YMNKTD/ColourPass-Vespera/design-log/part-05-colour-recognition-and-code-refinement/Colour Calibration Reference Table.xlsx

Colour | R | G | B | C | Ticket Type
RED | 153 | 1997 | 143 | 1328 | Invalid
ORANGE | 196 | 813 | 152 | 1147 | Invalid
PINK | 244 | 1177 | 159 | 681 | Invalid
YELLOW | 108 | 260 | 70 | 505 | Valid — Static
GREEN | 356 | 217 | 105 | 595 | Valid — Static
BLUE | 4852 | 1405 | 286 | 391 | Valid — Ambient
PURPLE | 483 | 1594 | 252 | 671 | Valid — Ambient
WHITE | 103 | 175 | 50 | 185 | N/A (prevent misidentification)
BLACK | 56 | 135 | 32 | 166 | N/A (prevent misidentification)
Background | 52 | 126 | 30 | 154 | N/A (prevent misidentification)
