YMNKTD/ColourPass-Vespera/design-log/part-01-colour-sensing/colour_sensor_testing_blue.jpg

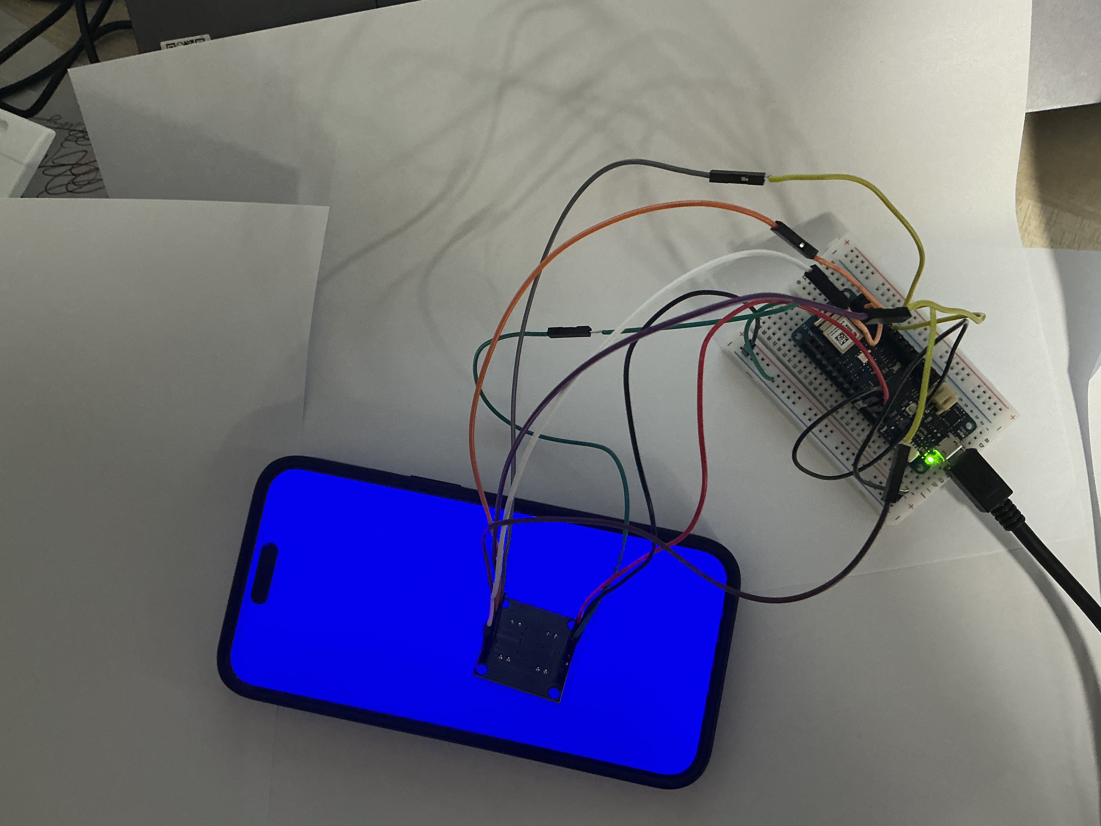
design-log/part-01-colour-sensing/colour_sensor_testing_blue.jpg
