YMNKTD/ColourPass-Vespera/design-log/part-01-colour-sensing/colour_sensor_testing_red.jpg

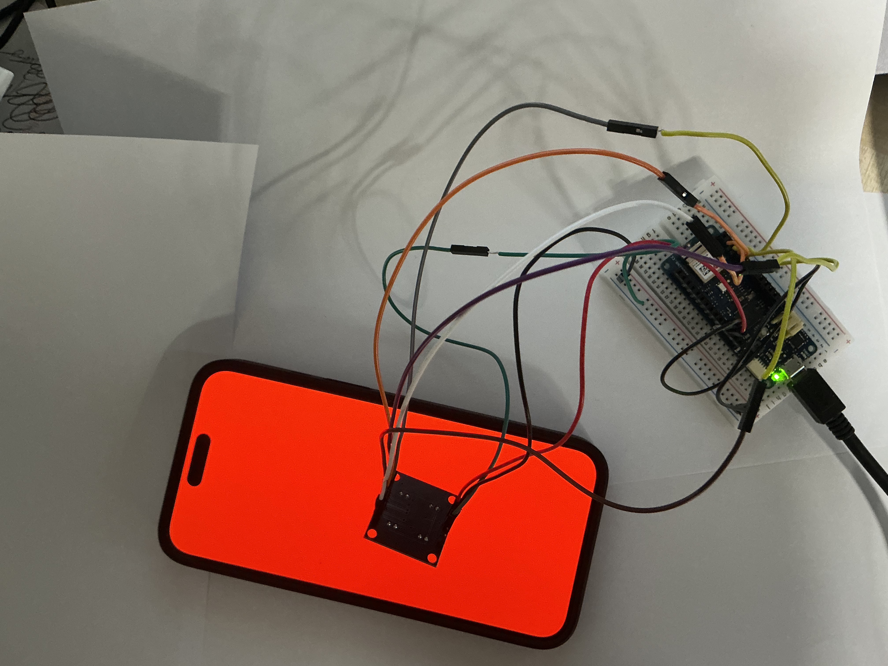
design-log/part-01-colour-sensing/colour_sensor_testing_red.jpg
