YMNKTD/ColourPass-Vespera/code/arduino_secrets.h.example.h

//Change this file before use
#define SECRET_SSID "Your Wifi"
#define SECRET_PASS "The Password of your Wifi"

#define SECRET_SSID1 ""
#define SECRET_PASS1 ""

#define SECRET_MQTTUSER ""
#define SECRET_MQTTPASS ""
