YMNKTD/ColourPass-Vespera/(commit log)

2026-10-20 Update design log with revised touch sensor design
    Added revised design details and clarified touch sensor functionality.
2026-10-25 Add log for Part 01 Colour Sensor Testing
    Document initial testing results and observations for the DFRobot colour sensor with Arduino MKR WiFi 1010.
2026-10-25 Upload some pictures of the circuit and testing
    Upload some pictures of the circuit and testing process for part 01
2026-10-25 Enhance README with sensor readings and testing method
    Added images of sensor readings for different colors and updated the testing method section.
2026-10-28 Add .gitkeep for hardware integration and calibration
2026-10-28 Create README for hardware integration and calibration
    Added README for hardware integration and colour calibration, detailing objectives, hardware components, testing procedures, and calibration steps.
2026-10-28 Update README with I2C testing result and code link
    Added I2C testing result image and code reference.
2026-10-28 Refactor ColourPass code for clarity and touch controls
    Refactor code for clarity and maintainability, updating variable names and restructuring functions to improve readability. Added touch control features for calibration and background checks.
2026-10-29 Upload the 1st version for the project
    In this version, colour still need to be detected after starting the prototype. Then, different modes can work smoothly.
2026-10-29 Upload some images of part 03
    The switch and the battery have been added to the circuit.
2026-10-30 Upload Part 04 pictures
    After this step, we can see the prototype. But I found some small issue in Part 03 and I gonna change it soon.
2026-10-30 Update README with prototype construction details
    Added detailed construction process and design iteration for the ColourPass prototype, including objectives, materials, and testing observations.
2026-10-31 Upload Colour Calibration Reference Table
2026-10-31 Revise README for Part 05 — Colour Recognition updates
    Updated README.md for Part 05 to include an overview of colour recognition improvements, on-site calibration details, code refinements for demonstration, lighting tests, and observations.
2026-11-01 Add initial concept and prototype design sketches
2026-11-01 Update version in serial print statement
