YMNKTD/ColourPass-Vespera/design-log/part-03-mqtt-integration-and-lighting-control/Vespera_Simulation_Test_Yellow.jpg

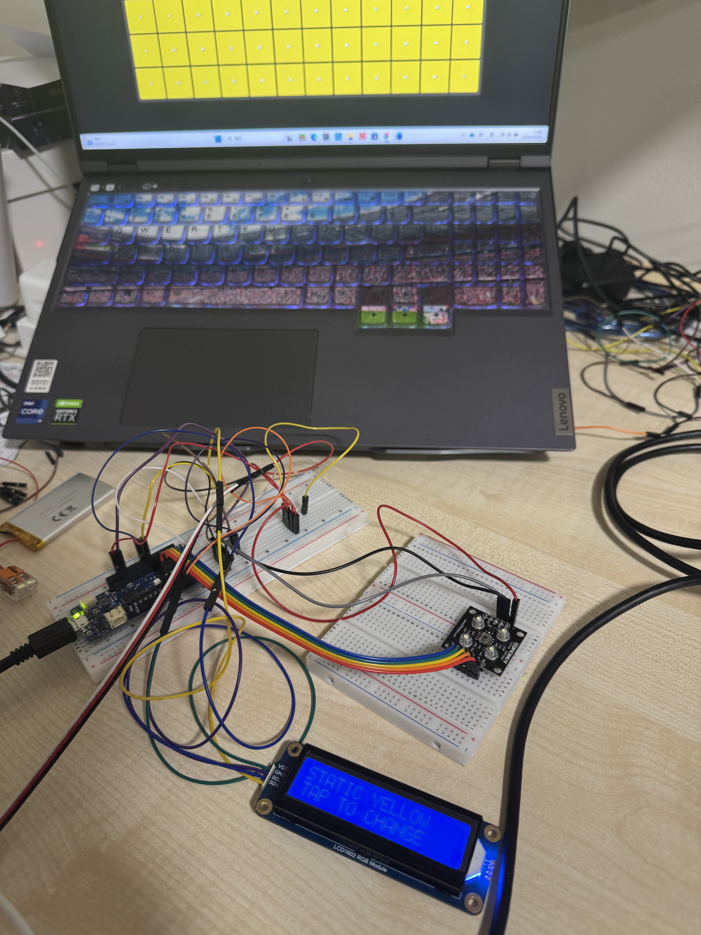
[picture p23: design-log/part-03-mqtt-integration-and-lighting-control/Vespera_Simulation_Test_Yellow.jpg]
design-log/part-03-mqtt-integration-and-lighting-control/Vespera_Simulation_Test_Yellow.jpg
