YMNKTD/ColourPass-Vespera/design-log/part-03-mqtt-integration-and-lighting-control/Vespera_Simulation_Test_BlueMood.jpg

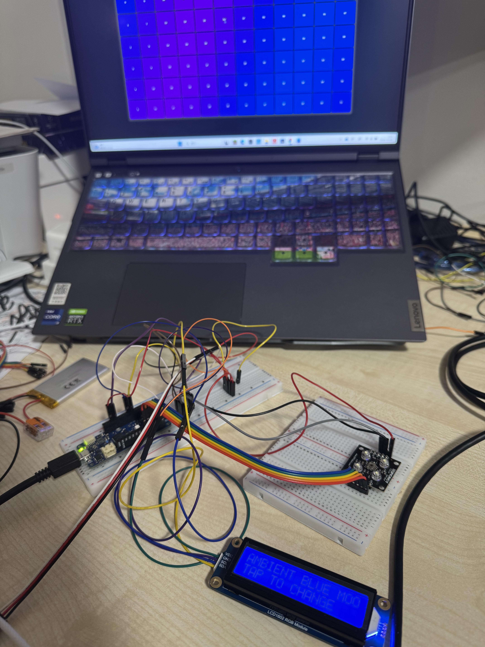
[picture p24: design-log/part-03-mqtt-integration-and-lighting-control/Vespera_Simulation_Test_BlueMood.jpg]
design-log/part-03-mqtt-integration-and-lighting-control/Vespera_Simulation_Test_BlueMood.jpg
