YMNKTD/ColourPass-Vespera/design-log/part-03-mqtt-integration-and-lighting-control/Vespera_Simulation_Test_Disco.jpg

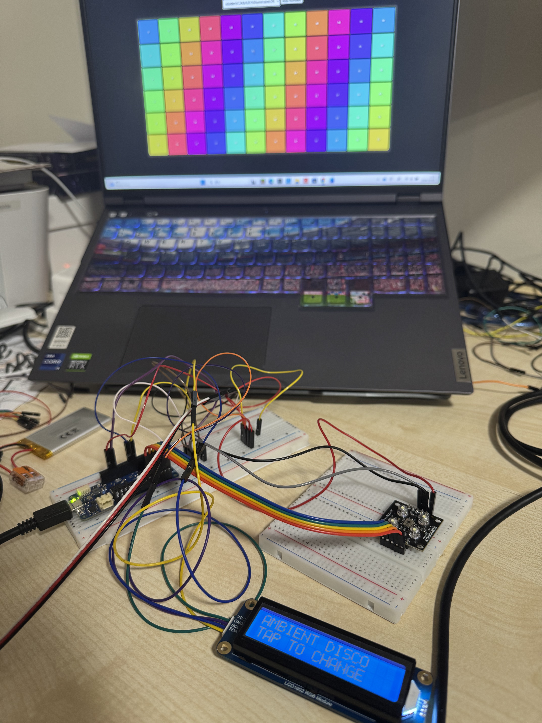
[picture p25: design-log/part-03-mqtt-integration-and-lighting-control/Vespera_Simulation_Test_Disco.jpg]
design-log/part-03-mqtt-integration-and-lighting-control/Vespera_Simulation_Test_Disco.jpg
