YMNKTD/ColourPass-Vespera/design-log/part-03-mqtt-integration-and-lighting-control/Vespera_Simulation_Test_FCBayern.jpg

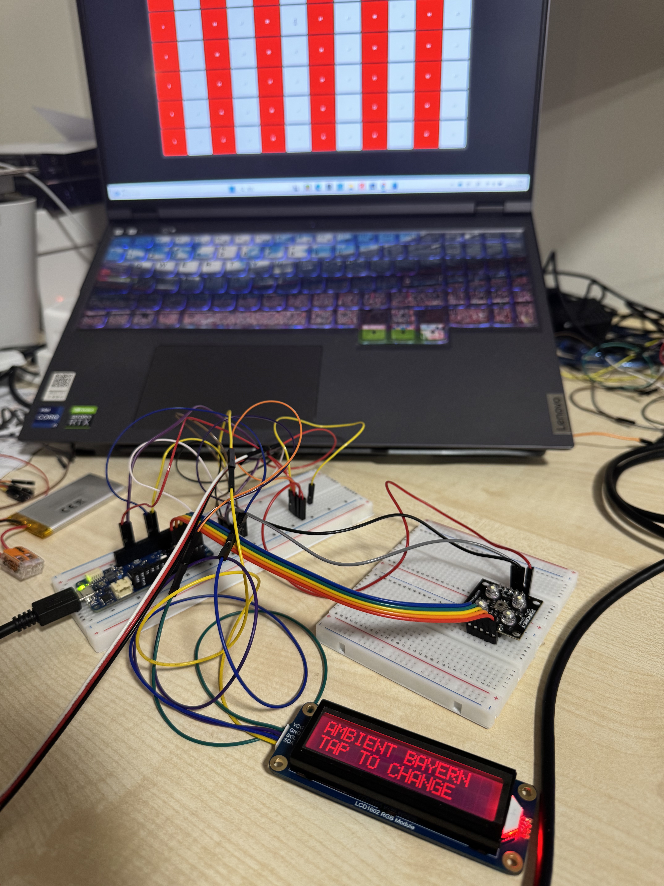
[picture p26: design-log/part-03-mqtt-integration-and-lighting-control/Vespera_Simulation_Test_FCBayern.jpg]
design-log/part-03-mqtt-integration-and-lighting-control/Vespera_Simulation_Test_FCBayern.jpg
